gaston-cb/aprilp/esquemáticos.pdf

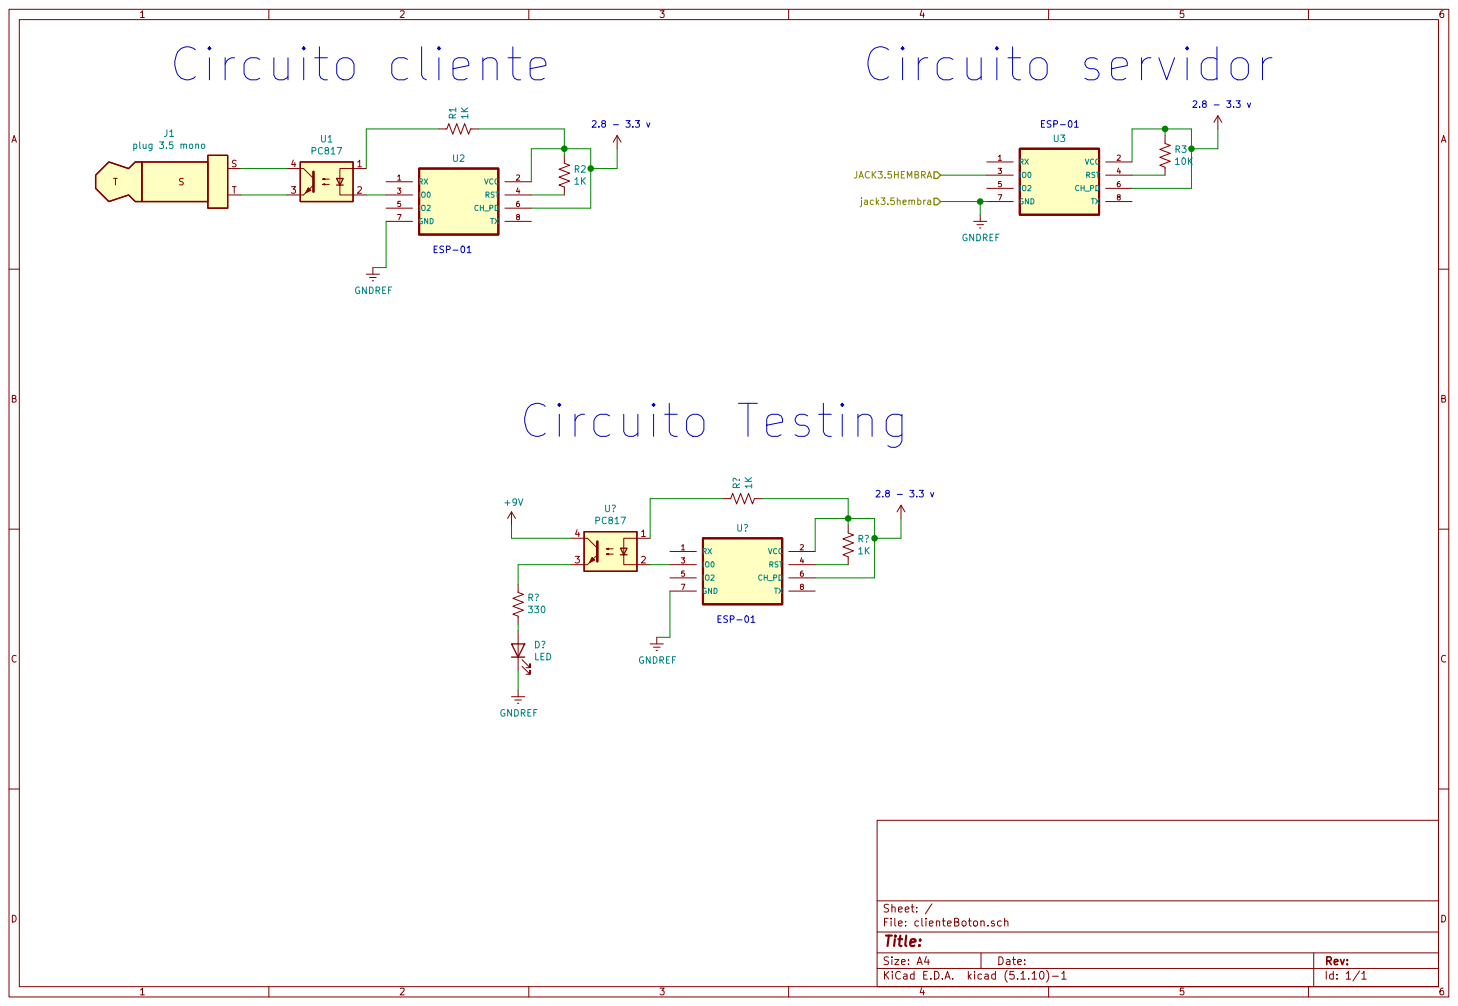
[picture p6: page 1]

Id: 1/1 Title: File: clienteBoton.sch Sheet: / R1 1K
