gaston-cb/aprilp/circuits_simulate_LTSPICE/PC817.asc

R1: res; 1k
R2: res; 10k
U1: PC817A
V1: voltage; 3
V2: voltage; 3
Named nets: 0
.dc V2 3 9 1
