gaston-cb/aprilp/ServidorBotonAprilp/include/macaddress.h

#define MAC_ADDRESS_ESPRESSIF_0 0x083AF2
#define MAC_ADDRESS_ESPRESSIF_1 0x0CDC7E
#define MAC_ADDRESS_ESPRESSIF_2 0x10521C
#define MAC_ADDRESS_ESPRESSIF_3 0x1091A8
#define MAC_ADDRESS_ESPRESSIF_4 0x1097BD
#define MAC_ADDRESS_ESPRESSIF_5 0x18FE34
#define MAC_ADDRESS_ESPRESSIF_6 0x1C9DC2
#define MAC_ADDRESS_ESPRESSIF_7 0x240AC4
#define MAC_ADDRESS_ESPRESSIF_8 0x2462AB
#define MAC_ADDRESS_ESPRESSIF_9 0x246F28
#define MAC_ADDRESS_ESPRESSIF_10 0x24A160
#define MAC_ADDRESS_ESPRESSIF_11 0x24B2DE
#define MAC_ADDRESS_ESPRESSIF_12 0x24D7EB
#define MAC_ADDRESS_ESPRESSIF_13 0x2C3AE8
#define MAC_ADDRESS_ESPRESSIF_14 0x2CF432
#define MAC_ADDRESS_ESPRESSIF_15 0x308398
#define MAC_ADDRESS_ESPRESSIF_16 0x30AEA4
#define MAC_ADDRESS_ESPRESSIF_17 0x30C6F7
#define MAC_ADDRESS_ESPRESSIF_18 0x34865D
#define MAC_ADDRESS_ESPRESSIF_19 0x349454
#define MAC_ADDRESS_ESPRESSIF_20 0x34AB95
#define MAC_ADDRESS_ESPRESSIF_21 0x34B472
#define MAC_ADDRESS_ESPRESSIF_22 0x3C6105
#define MAC_ADDRESS_ESPRESSIF_23 0x3C71BF
#define MAC_ADDRESS_ESPRESSIF_24 0x409151
#define MAC_ADDRESS_ESPRESSIF_25 0x40F520
#define MAC_ADDRESS_ESPRESSIF_26 0x441793
#define MAC_ADDRESS_ESPRESSIF_27 0x483FDA
#define MAC_ADDRESS_ESPRESSIF_28 0x485519
#define MAC_ADDRESS_ESPRESSIF_29 0x4C11AE
#define MAC_ADDRESS_ESPRESSIF_30 0x4C7525
#define MAC_ADDRESS_ESPRESSIF_31 0x4CEBD6
#define MAC_ADDRESS_ESPRESSIF_32 0x500291
#define MAC_ADDRESS_ESPRESSIF_33 0x545AA6
#define MAC_ADDRESS_ESPRESSIF_34 0x58BF25
#define MAC_ADDRESS_ESPRESSIF_35 0x5CCF7F
#define MAC_ADDRESS_ESPRESSIF_36 0x600194
#define MAC_ADDRESS_ESPRESSIF_37 0x6055F9
#define MAC_ADDRESS_ESPRESSIF_38 0x686725
#define MAC_ADDRESS_ESPRESSIF_39 0x68C63A
#define MAC_ADDRESS_ESPRESSIF_40 0x70039F
#define MAC_ADDRESS_ESPRESSIF_41 0x782184
#define MAC_ADDRESS_ESPRESSIF_42 0x78E36D
#define MAC_ADDRESS_ESPRESSIF_43 0x7C87CE
#define MAC_ADDRESS_ESPRESSIF_44 0x7C9EBD
#define MAC_ADDRESS_ESPRESSIF_45 0x7CDFA1
#define MAC_ADDRESS_ESPRESSIF_46 0x807D3A
#define MAC_ADDRESS_ESPRESSIF_47 0x840D8E
#define MAC_ADDRESS_ESPRESSIF_48 0x84CCA8
#define MAC_ADDRESS_ESPRESSIF_49 0x84F3EB
#define MAC_ADDRESS_ESPRESSIF_50 0x84F703
#define MAC_ADDRESS_ESPRESSIF_51 0x8C4B14
#define MAC_ADDRESS_ESPRESSIF_52 0x8CAAB5
#define MAC_ADDRESS_ESPRESSIF_53 0x8CCE4E
#define MAC_ADDRESS_ESPRESSIF_54 0x90380C
#define MAC_ADDRESS_ESPRESSIF_55 0x9097D5
#define MAC_ADDRESS_ESPRESSIF_56 0x943CC6
#define MAC_ADDRESS_ESPRESSIF_57 0x94B97E
#define MAC_ADDRESS_ESPRESSIF_58 0x98CDAC
#define MAC_ADDRESS_ESPRESSIF_59 0x98F4AB
#define MAC_ADDRESS_ESPRESSIF_60 0x9C9C1F
#define MAC_ADDRESS_ESPRESSIF_61 0xA020A6
#define MAC_ADDRESS_ESPRESSIF_62 0xA0764E
#define MAC_ADDRESS_ESPRESSIF_63 0xA47B9D
#define MAC_ADDRESS_ESPRESSIF_64 0xA4CF12
#define MAC_ADDRESS_ESPRESSIF_65 0xA4E57C
#define MAC_ADDRESS_ESPRESSIF_66 0xA8032A
#define MAC_ADDRESS_ESPRESSIF_67 0xA848FA
#define MAC_ADDRESS_ESPRESSIF_68 0xAC0BFB
#define MAC_ADDRESS_ESPRESSIF_69 0xAC67B2
#define MAC_ADDRESS_ESPRESSIF_70 0xACD074
#define MAC_ADDRESS_ESPRESSIF_71 0xB4E62D
#define MAC_ADDRESS_ESPRESSIF_72 0xB8F009
#define MAC_ADDRESS_ESPRESSIF_73 0xBCDDC2
#define MAC_ADDRESS_ESPRESSIF_74 0xBCFF4D
#define MAC_ADDRESS_ESPRESSIF_75 0xC44F33
#define MAC_ADDRESS_ESPRESSIF_76 0xC45BBE
#define MAC_ADDRESS_ESPRESSIF_77 0xC4DD57
#define MAC_ADDRESS_ESPRESSIF_78 0xC82B96
#define MAC_ADDRESS_ESPRESSIF_79 0xC8C9A3
#define MAC_ADDRESS_ESPRESSIF_80 0xCC50E3
#define MAC_ADDRESS_ESPRESSIF_81 0xD4F98D
#define MAC_ADDRESS_ESPRESSIF_82 0xD8A01D
#define MAC_ADDRESS_ESPRESSIF_83 0xD8BFC0
#define MAC_ADDRESS_ESPRESSIF_84 0xD8F15B
#define MAC_ADDRESS_ESPRESSIF_85 0xDC4F22
#define MAC_ADDRESS_ESPRESSIF_86 0xE09806
#define MAC_ADDRESS_ESPRESSIF_87 0xE0E2E6
#define MAC_ADDRESS_ESPRESSIF_88 0xE868E7
#define MAC_ADDRESS_ESPRESSIF_89 0xE89F6D
#define MAC_ADDRESS_ESPRESSIF_90 0xE8DB84
#define MAC_ADDRESS_ESPRESSIF_91 0xEC94CB
#define MAC_ADDRESS_ESPRESSIF_92 0xECFABC
#define MAC_ADDRESS_ESPRESSIF_93 0xF008D1
#define MAC_ADDRESS_ESPRESSIF_94 0xF4CFA2
#define MAC_ADDRESS_ESPRESSIF_95 0xFCF5C4
