gaston-cb/aprilp/(commit log)

2021-09-19 version cambiando de ventanas-- solo funciona en chrome
2021-09-20 web sockets testeados-- agregados
2021-09-21 version con reconocimiento de IP de clientes
2021-09-21 versionado con reconocimientos de clientes
2021-09-21 ips clientes obtenidas -- proximo paso reconocer Ips de ESP usando mac address
2021-10-08 push button add
2021-10-08 button input and recognize address espressifs macs add
2021-10-09 lectura del cliente correcta
    [main.cpp]
2021-10-10 version final -- faltan comentarios en el codigo
2021-10-10 inicio de comentarios en receptor
2021-10-10 fin de comentarios sobre el cliente, faltan comentarios en servidor
2021-10-10 readme.md materiales y programacion esp01, faltan imagenes de circuito
2021-10-10 versiones de software añadidas
2021-10-11 documentacion de folders
2021-10-11 descripcion de funciones realizadas
2021-10-11 esquemáticos agregados
    [clienteBoton.kicad_pcb, clienteBoton.sch]
2021-11-18 circuit simulate init results
